ljiang09/3D-Scanner/ReadMe.md

# PIE Mini-Project 2: DIY 3D Scanner

## Objectives

1. Build and program a rudimentary 3D scanner using a pan/tilt mechanism
2. Scan an object of known, well-defined geometry
3. Visualize the output from your scanner
