ljiang09/3D-Scanner/main.py

"""
Driver file for calibration curves and sensor visualization.

Generates a sensor calibration curve, validates the curve.
Listens for data from the Arduino scanner, generates a 3D visualization of the scanned object
"""
import serial
import sensor_calibration as calibrate
import python_receive_data as prd

# Link to port for communication with Arduino
ARDUINO_COM_PORT = "/dev/ttyACM0" # Check with port from Arduino
BAUD_RATE = 9600   # This value must be the exact same as in the Arduino code

# CANNOT have serial monitor or plotter open in Arduino to run this
SERIAL_PORT = serial.Serial(ARDUINO_COM_PORT, BAUD_RATE, timeout=10) 

# Calibrate, plot, and fetch parameters of sensor reading vs. distance equation
PARAMS = calibrate.run_calibration()

# Fetch data until STOP command given
SENSOR_VOLT, POSITIONS, POSITIONS_DEGREES, RADII = \
    prd.fetch_data(SERIAL_PORT, get_data=True, params=PARAMS)

# Generate scatterplot in XYZ dimensions
prd.plot_heatmap(POSITIONS)

# Uncomment to generate pan-angle vs radii plot (1d)
# prd.plot_single_sweep(POSITIONS_DEGREES, SENSOR_VOLT, PARAMS)
