ljiang09/3D-Scanner/(commit log)

2022-09-20 add sensor calibration plotting script
2022-09-21 Add sample scripts from class
2022-09-21 Convert sensor_calibratio to python
2022-09-22 Add test for calibration curve
2022-09-26 Add commands for servo 2 movement
2022-09-26 add x-y positions to serial prints
2022-09-26 add full 180 degrees to servo range of motion
2022-09-26 Plot data from arduino
2022-09-27 Fix spherical coordination portion
    [python_receive_data.py]
2022-09-27 add start/end servo angles
2022-09-28 Fixed formula for exponential
    [ArduinoSendData.ino, python_receive_data.py, sensor_calibration.py]
2022-09-28 Add somewhat good graph
    [n_data.csv, n_data1.csv, recording_data.csv, recording_data1.csv]
2022-09-28 Finish all visualization
    [n_data.csv, n_data1.csv, n_data2.csv, recording_data.csv, recording_data1.csv, recording_data2.csv]
2022-09-28 Fix testing calibration and document
    [main.py, python_receive_data.py, sensor_calibration.py]
2022-09-28 Remove unnecessary files
    [n_data1.csv, n_data2.csv, recording_data1.csv, recording_data2.csv]
2022-09-28 add comments and replace with right file
    [ArduinoSingleSweep.ino]
2022-09-29 Fix angles for visualization
    [ArduinoSendData.ino, ArduinoSingleSweep.ino, main.py, python_receive_data.py]
2022-09-29 Remove unnecessary print
